liujiajia-wq/DC-Motor-PID-Speed-Control-Based-on-STM32-and-Modbus/STM32直流电机PID闭环调速系统_项目技术文档.docx

嵌入式运动控制 · 项目技术文档

基于 STM32F103C8T6 与 Modbus-RTU 的
直流电机增量式 PID 闭环调速系统

硬件设计 · 下位机固件 · Qt 上位机 · 通信协议 · 参数整定

文档类型：项目技术文档（设计 / 实现 / 调试全记录）
硬件平台：STM32F103C8T6 + TB6612FNG + 11 线光电编码器
软件平台：STM32CubeMX + HAL 库 + Keil MDK-ARM 5 / Qt 5.9
控制算法：增量式 PID，控制周期 100 ms，PWM 频率 1 kHz
通信方式：Modbus-RTU 从机，USART2，115200 bps，站号 0x01
文档版本：V1.0　　编写日期：2026 年 10 月 27 日

本文档依据工程源码逐文件核对编写，凡与代码不一致处均以代码实现为准

目 录

## 摘要

本项目以 STM32F103C8T6 为核心控制器，构建了一套"编码器测速—增量式 PID 运算—PWM 调压"的直流电机速度闭环系统。系统采用 TB6612FNG 双通道 H 桥驱动 12 V 减速直流电机，通过 TIM3 的正交解码功能读取电机轴端光电编码器脉冲，以 100 ms 为控制周期计算转速并执行增量式 PID 运算，输出 1 kHz PWM 占空比驱动电机；同时以 USART2 承载 Modbus-RTU 从机协议，与基于 Qt 5.9 开发的 PC 上位机通信，实现目标速度下发、启停与正反转控制、目标/实际速度实时回传与响应曲线绘制；板载 0.96 寸 I²C OLED 同步显示目标值、实测值与当前 PWM 输出。

本文档按照"总体设计—硬件设计—下位机软件—上位机软件—通信协议—参数整定—调试排故"的顺序，完整记录该项目的设计依据、关键参数推导、模块实现要点与实测调参过程，并单列一章说明既有文档与当前代码之间的差异、以及代码中尚未闭环的已知问题，供后续维护与二次开发参考。

关键词：STM32F103C8T6；增量式 PID；TB6612FNG；正交编码器；Modbus-RTU；Qt 上位机

## 1 项目概述

本章说明项目的立论依据、要实现的功能边界与可验收的技术指标，并统一后文使用的术语与记号。

### 1.1 项目背景

直流减速电机具有转矩大、响应快、调速方便的特点，是小型移动机器人、传送机构、云台与教学实验平台最常见的执行器。开环调速直接给定 PWM 占空比，电机实际转速会随负载、电源电压、温升与摩擦变化而漂移，无法满足"设定多少就跑多少"的需求。

引入编码器构成闭环后，转速成为可控量。相比位置式 PID，增量式 PID 的输出是占空比的"增量"，天然不含积分累积项的历史包袱，切换目标值或停机时不需要额外清积分，抗积分饱和、抗扰能力更强，非常适合以 PWM 为执行量的电机调速场景，因此本项目选用增量式 PID 作为核心算法。

### 1.2 设计目标与功能清单

- 电机速度闭环：以 100 ms 为周期测量实际转速并执行增量式 PID，稳态转速跟随设定值；
- 方向与启停控制：支持正转、反转、停止三种运行状态，停止时立即封锁 PWM 并清零 PID 状态；
- 手动调速：目标速度以 0~100 的无量纲档位表示，与 0~100% 占空比等量映射；
- 本地显示：OLED 实时显示目标速度、实际速度与 PID 输出的 PWM 值；
- 远程通信：Modbus-RTU 从机，支持 0x03 读寄存器、0x06 写寄存器，可由任意 Modbus 主站或调试助手访问；
- 上位机监控：Qt 桌面程序完成串口配置、电机操作、目标/实际速度双曲线绘制与原始报文日志；
- 可维护性：各功能按模块拆分（驱动、测速、算法、通信、显示），便于单独替换与移植。

### 1.3 主要技术指标

项目 | 指标 | 依据
主控 | STM32F103C8T6，Cortex-M3，72 MHz，64 KB Flash / 20 KB RAM | 最小系统板
电机 | 12 V 减速直流电机，输出轴 170 rpm，减速比 1:8 | 实测铭牌参数
编码器 | 11 线光电增量式，A/B 双相，四倍频后 44 计数/转（电机轴） | 编码器规格
调速范围 | 0~100 档（对应 0~100% 占空比），实测下限约 15~20 档 | 实测
PWM 频率 | 1 kHz（TIM4：72 MHz / 72 / 1000） | MX_TIM4_Init
控制周期 | 100 ms（测速 + PID + PWM 更新） | main.c 软定时
通信 | USART2，115200 bps，8 数据位，无校验，1 停止位 | MX_USART2_UART_Init
协议 | Modbus-RTU 从机，站号 0x01，功能码 0x03 / 0x06 | modbus.c
显示 | 0.96 寸 OLED，SSD1306，I²C 100 kHz | i2c.c / oled.c
稳态性能 | 稳态误差 0（回读计数等于目标值），无明显持续振荡 | 实测

### 1.4 术语与记号

术语 | 含义
CCR | 定时器比较寄存器值，决定 PWM 高电平计数值
ARR | 定时器自动重装载值，决定 PWM 周期
占空比 | CCR / (ARR + 1) × 100%，本项目取 0~99 对应 0~99%
计数 | 本文特指"100 ms 内编码器四倍频脉冲个数"，即转速的数字化表示，量纲 计数/100 ms
增量式 PID | 输出为控制量增量的 PID 形式，需累加得到实际控制量
帧间隔 | Modbus-RTU 中用于划分报文边界的静默时间，本项目取 5 ms

## 2 系统总体设计

在进入具体电路与代码之前，先给出系统的分层组成、闭环数据流、时间基准与量纲约定——这四项决定了后续所有模块的实现方式。

### 2.1 系统组成

系统按职责分为四层：

- 执行层：TB6612FNG 与直流减速电机，接收方向电平与 PWM，输出机械转速；
- 传感层：电机轴端 11 线光电编码器，把转速转换为正交脉冲；
- 控制层：STM32F103C8T6，完成测速、PID 运算、PWM 生成、协议解析与显示刷新；
- 交互层：0.96 寸 OLED（本地）与 Qt 上位机（远程，经 USB-TTL 与 USART2 相连）。

┌──────────── 上位机（Qt 5.9） ────────────┐
│ 串口配置 / 启停 / 调速 / 双曲线 / 报文日志 │
└───────────────┬──────────────────────────┘
│ USB（虚拟串口，115200 8N1）
┌─────┴─────┐
│ CH340 TTL │
└─────┬─────┘
PA2(TX)/PA3(RX) ← Modbus-RTU
┌───────────────┴──────────────────────────────┐
│ STM32F103C8T6 @72 MHz │
│ TIM3 正交解码测速 → 增量式 PID → TIM4 PWM │
│ I2C1 → OLED USART2 → Modbus 从机 │
└───────┬───────────────────────┬──────────────┘
PA6/PA7 │ PB6 PWM│ PB0/PB1 方向
┌───────┴────────┐ ┌───────┴────────┐
│ 11 线编码器 A/B │ │ TB6612FNG │
└───────┬────────┘ └───────┬────────┘
│ 同轴 12V │
┌───┴────────────────────────┴───┐
│ 12 V 减速直流电机（1:8, 170rpm）│
└───────────────────────────────┘

### 2.2 控制回路与数据流

单个控制周期内，数据沿"测量 → 比较 → 决策 → 执行"的闭环流动：

1. 读取 TIM3 计数器，与上一周期值作差得到本周期的编码器增量，取绝对值作为实际速度反馈；
2. 与 Modbus 写入的目标速度求偏差 e(k)；
3. 增量式 PID 计算占空比增量并累加到 pwm_out，限幅到 0~99；
4. 按当前命令字设置 AIN1/AIN2 方向电平，并把 pwm_out 写入 TIM4 CCR1；
5. 同时把目标值、实测值、PWM 值刷到 OLED；Modbus 主站的读请求在任意时刻由主循环响应，返回最近一次有效的目标值与实测值。

### 2.3 时间基准与任务调度

系统未使用 RTOS，全部任务由主循环 + 一个串口接收中断构成，节奏由 HAL_GetTick() 软定时和字节中断的静默时间共同决定。

任务 | 触发方式 | 周期/条件 | 实现位置
串口字节接收 | USART2 接收中断 | 每字节一次 | HAL_UART_RxCpltCallback()
帧边界判定 | 轮询 | 接收静默 ≥ 5 ms | Modbus_Parse()
测速 + PID + PWM | 软定时 | 100 ms | Motor_PID_Loop()
OLED 刷新 | 跟随 PID 节拍 | 100 ms | Motor_PID_Loop() 内
上位机轮询读 | Qt 定时器 | 200 ms | MainWindow::slotAutoReadSpeed()

说明：控制周期用软定时而非硬件定时中断，好处是不占用中断资源、便于在线调整周期；代价是周期存在主循环阻塞带来的抖动（OLED 的 I²C 阻塞发送是主要来源）。当串口报文密集时，抖动会略微增大，但对 100 ms 级别的速度环影响可忽略。

### 2.4 量纲统一与速度标定

闭环要成立，反馈量与设定量必须同量纲。本项目刻意把"速度"定义为"100 ms 内的编码器计数"，让 100 这个数字同时对应"满速"与"100% 占空比"，从而把 PID 参数化为无量纲形式。推导如下：

- 编码器 11 线，A/B 双相四倍频后每转计数 = 11 × 4 = 44；
- 减速比 1:8，输出轴 170 rpm 时电机轴转速 = 170 × 8 = 1360 rpm ≈ 22.67 r/s；
- 每秒计数 = 22.67 × 44 ≈ 997.3；
- 100 ms 内计数 = 997.3 × 0.1 ≈ 99.7，取整为 100。

因此 计数/100 ms ≈ 占空比%，反馈量与控制量数值可比，Kp 可以直接理解为"每 1 个计数偏差对应多少个百分点的占空比增量"，整定时无需再换算量纲。

一致性提示：由于四倍频与减速比固定，上式成立的前提是 TIM3 工作在编码器模式且不额外分频（PSC=0）。若更换编码器线数或减速比，必须重新标定该映射，否则 PID 参数需整体重调。

### 2.5 工程文件组织

下位机工程由 STM32CubeMX 生成骨架，用户功能代码以独立 .c/.h 文件放在 Core/Src 与 Core/Inc 下。

文件 | 职责
Core/Src/main.c | 初始化调度、主循环、100 ms PID 节拍
Core/Src/DCmotor.c/.h | TB6612 方向控制、PWM 占空比、增量式 PID
Core/Src/encode.c | 编码器定时器启动与增量读取
Core/Src/modbus.c/.h | CRC16、报文解析、寄存器读写、应答发送
Core/Src/usart.c | USART2 配置与单字节接收中断回调
Core/Src/tim.c | TIM1/2/3/4 的 CubeMX 配置
Core/Src/gpio.c / i2c.c | 引脚与 I²C1（OLED）配置
Core/Src/oled.c | SSD1306 驱动与字符显示
Core/Src/SG90.c | 舵机控制（前序实验遗留，当前未参与主流程）
MDK-ARM/*.uvprojx | Keil MDK 工程
STM32F103C8T6_MOTOR.ioc | CubeMX 工程配置
上位机-QT/Modbus/ModbusRtu | Qt 上位机源码

## 3 硬件设计

本章按“主控—驱动—传感—显示—通信”的顺序给出各模块的选型依据、关键参数与接线关系，并集中列出全部引脚分配，便于照表接线与逐点排查。

### 3.1 主控最小系统

STM32F103C8T6 采用 LQFP48 封装，片上 64 KB Flash、20 KB SRAM，最高主频 72 MHz。系统时钟由外部 8 MHz 晶振经 PLL ×9 倍频得到 72 MHz；AHB 不分频（72 MHz），APB2 不分频（72 MHz），APB1 二分频（36 MHz）。定时器时钟方面，APB2 上的 TIM1 为 72 MHz，APB1 上的 TIM2/3/4 经倍频后同为 72 MHz，这也是后文 PWM 频率计算的基准。

调试接口使用 SWD（PA13/PA14），板载 PC13 LED 已在 GPIO 初始化时置高（熄灭），当前仅作为可用指示灯保留。

### 3.2 引脚分配

引脚 | 复用/方向 | 外设与配置 | 连接对象 | 说明
PA0 | 输入（上拉） | TIM2_CH1，编码器模式 | EC11 旋钮 A 相 | 前序实验预留，当前未启用
PA1 | 输入（上拉） | TIM2_CH2，编码器模式 | EC11 旋钮 B 相 | 同上
PA2 | 复用推挽 | USART2_TX | CH340 RXD | Modbus 发送
PA3 | 浮空输入 | USART2_RX | CH340 TXD | Modbus 接收，开中断
PA6 | 浮空输入 | TIM3_CH1，编码器模式 | 电机编码器 A 相 | 测速
PA7 | 浮空输入 | TIM3_CH2，编码器模式 | 电机编码器 B 相 | 测速
PA8 | 复用推挽 | TIM1_CH1（50 Hz） | SG90 信号 | 前序实验遗留
PA9 | 复用推挽 | TIM1_CH2（50 Hz） | 预留 | 前序实验遗留
PA13/PA14 | SWD | SYS_JTMS/JTCK | 调试器 | 下载调试
PB0 | 推挽输出 | GPIO_OUTPUT | TB6612 AIN1 | 方向控制
PB1 | 推挽输出 | GPIO_OUTPUT | TB6612 AIN2 | 方向控制
PB6 | 复用推挽 | TIM4_CH1（1 kHz PWM） | TB6612 PWMA | 调速
PB8 | 复用开漏 | I2C1_SCL（重映射） | OLED SCL | 显示
PB9 | 复用开漏 | I2C1_SDA（重映射） | OLED SDA | 显示
PC13 | 推挽输出 | GPIO_OUTPUT | 板载 LED | 备用指示

注意：PB6 与 PB8/PB9 的 I²C 重映射共存于同一端口，CubeMX 中必须勾选 I2C1 重映射，否则 OLED 无显示。

### 3.3 电机驱动 TB6612FNG

TB6612FNG 内部为双 H 桥，单通道持续电流 1.2 A、峰值 3.2 A，支持 2.5~13.5 V 电机电源，逻辑侧 2.7~5.5 V，控制接口为"1 路 PWM + 2 路方向"。本项目只使用 A 通道：

STBY | AIN1 | AIN2 | PWMA | 电机状态
高 | 1 | 0 | PWM | 正转，转速随占空比
高 | 0 | 1 | PWM | 反转，转速随占空比
高 | 1 | 1 | × | 短路制动（快速刹车）
高 | 0 | 0 | × | 停止（滑行）
低 | × | × | × | 待机，输出高阻

固件中 Motor_Forward()/Motor_Backward()/Motor_Brake()/Motor_Stop() 四个函数分别对应上述四种状态，Motor_Run(mode, speed) 在其上再叠加占空比设置。STM32 侧只占用 3 个引脚（PB0、PB1、PB6），VM 接 12 V 电机电源，VCC 接 3.3 V 逻辑电源，GND 与主控、电源共地。

STBY 在代码中未被驱动，需硬件直接接 VCC（或 3.3 V）保持常使能，否则芯片处于待机、电机不动。

### 3.4 编码器接口

编码器为 11 线光电增量式，A/B 两相正交输出，安装于电机后端轴（减速箱之前），因此计数反映的是电机轴转速而非输出轴转速。TIM3 配置为编码器模式 TIM_ENCODERMODE_TI12，两路输入均直连 TI1/TI2，PSC=0、ARR=65535，即 16 位自由计数、硬件自动四倍频、方向由硬件根据 A/B 相位关系判断（计数器自增/自减）。

固件读取方式为"差分法"：每 100 ms 取一次计数值，与上次值相减得到增量。由于 16 位计数器会回绕，差值必须按有符号 16 位解释，代码中写作：

int16_t get_BMQ370_encode_delte(void)
{
uint16_t now_cnt = __HAL_TIM_GET_COUNTER(&htim3);
int16_t delta = (int16_t)(now_cnt - last_cnt); /* 16 位回绕自动正确 */
last_cnt = now_cnt;
return abs(delta); /* 当前仅取幅值 */
}

采用差分而非"清零重计"，避免了每周期写 CNT 带来的丢脉冲风险；abs() 使反馈只保留转速幅值，方向完全由命令字决定，因此本系统不具备"反向制动"能力（详见 §8.3）。

### 3.5 显示与人机接口

OLED 为 0.96 寸 SSD1306，128×64 单色，I²C 接口，7 位地址 0x3C，SCL 100 kHz。固件 oled.c 内置 6×8 与 8×16 字库，oled_show_string(x, y, str) 中 y 为页地址（每页 8 行像素）。当前界面占用 4 行：

行（页） | 内容 | 示例
0 | 目标速度 | target:060
2 | 实际速度 | real:058
4 | 编码器计数 | cnt:01234
6 | PID 输出占空比 | pwm:62.35

### 3.6 通信接口

PC 与 STM32 之间使用 CH340 USB 转 TTL 模块，仅接 TXD/RXD/GND 三线（无硬件流控）。波特率 115200，8N1。CH340 的 TXD 接 PA3（MCU 的 RX），RXD 接 PA2（MCU 的 TX），交叉连接；若接成同名相连则表现为"能发不能收"或完全无响应。

### 3.7 供电与抗干扰

- 12 V 电机电源与 3.3 V 逻辑电源分开供电，共地单点汇合，避免电机换向瞬间的电流冲击拉低 MCU 电压导致复位；
- 电机两端并联 0.1 μF 瓷片电容抑制换向火花，编码器信号线使用双绞或屏蔽线并远离电机引线；
- TB6612 的 VM 就近放置 100 μF 电解 + 0.1 μF 瓷片去耦；
- 若出现"电机一转上位机就掉线"，优先检查共地质量与 USB 供电是否与电机电源共地形成地环路。

## 4 下位机软件设计

下位机软件以 STM32CubeMX 生成的 HAL 骨架为基础，用户功能按驱动、测速、算法、通信、显示五个模块拆分；模块之间通过三个全局状态量（目标速度、实测速度、命令字）耦合，结构简单、易于在线调试。

### 4.1 开发环境与外设配置

- IDE：Keil MDK-ARM 5（工程 MDK-ARM/STM32F103C8T6_MOTOR.uvprojx）；
- 配置工具：STM32CubeMX（工程 STM32F103C8T6_MOTOR.ioc）；
- 驱动库：STM32F1xx HAL Driver；
- 下载调试：SWD，ST-Link / DAP-Link 均可。

外设配置汇总：

外设 | 工作模式 | 关键参数 | 计算结果 | 用途
TIM1 | PWM，CH1/CH2 | PSC=71，ARR=19999 | 72 MHz/72/20000 = 50 Hz | 舵机信号（遗留）
TIM2 | 编码器 TI12 | PSC=0，ARR=65535 | 16 位四倍频计数 | EC11（未启用）
TIM3 | 编码器 TI12 | PSC=0，ARR=65535，IC2 下降沿 | 16 位四倍频计数 | 电机测速
TIM4 | PWM，CH1 | PSC=71，ARR=999 | 72 MHz/72/1000 = 1 kHz | 电机调速
USART2 | 异步 | 115200 8N1，NVIC 优先级 6 | — | Modbus-RTU
I2C1 | 主机 | 100 kHz，7 位地址，重映射 | — | OLED
SysTick | 1 ms | HAL 时基 | — | HAL_GetTick()

### 4.2 初始化流程

main() 的执行顺序为：HAL_Init() → SystemClock_Config()（HSE 8 MHz ×9 = 72 MHz）→ MX_GPIO_Init() → MX_TIM1_Init() → MX_TIM2_Init() → MX_I2C1_Init() → MX_TIM3_Init() → MX_TIM4_Init() → MX_USART2_UART_Init() → 用户初始化。

用户初始化段完成四件事：

1. oled_init() 点亮并清屏；
2. init_BMQ370_encode_tim() 启动 TIM3 编码器接口；
3. Motor_init() 启动 TIM4 的 PWM 通道（此时 CCR=0，电机不转）；
4. 以单字节模式开启 USART2 接收中断，进入"来一个字节进一次中断"的接收方式。

### 4.3 主循环与 100 ms 节拍

主循环是典型的"非阻塞轮询 + 软定时"结构：

while (1)
{
Modbus_Parse(); /* 每圈都尝试解析，内部自判帧边界 */

if (HAL_GetTick() - pid_time >= 100) /* 100 ms 到点 */
{
pid_time = HAL_GetTick();
Motor_PID_Loop(); /* 测速 + PID + PWM + 显示 */
}
}

Modbus_Parse() 内部自带帧完整性判断（静默 ≥5 ms 且长度合法才处理），因此放在主循环高频调用是安全的；PID 任务用"当前节拍减上一节拍"的方式定时，不依赖中断，便于调试时临时改周期观察响应。

### 4.4 PWM 输出模块

TIM4 计数时钟 1 MHz（72 MHz / 72），ARR=999 → PWM 周期 1 ms（1 kHz），CCR 取值 0~999 对应 0~100% 占空比。Motor_SetSpeed(speed) 把 0~100 的档位换算为 CCR：

void Motor_SetSpeed(uint8_t speed)
{
if (speed > 100) speed = 100;
uint16_t arr = 999;
uint16_t ccr = (speed * arr) / 100;
__HAL_TIM_SET_COMPARE(&htim4, TIM_CHANNEL_1, ccr);
}

选择 1 kHz 而非更高频率，是为了兼顾两方面：频率太低（<200 Hz）电机有可闻啸叫与明显转矩脉动；频率太高则 H 桥开关损耗与驱动板发热上升，且在低速小占空比时线性度变差。1 kHz 是小型有刷直流电机常见的工作点。

### 4.5 测速模块

测速逻辑已在 §3.4 说明，此处补充工程上的两点处理：

- 读取时机固定：测速只在 Motor_PID_Loop() 内调用一次，保证"一个控制周期一次采样"，避免不同调用点的采样窗口不一致导致速度值跳动；
- 无效帧处理：若电机被外力堵转或静止，增量为 0，PID 会持续增大输出直至限幅，属正常闭环行为，需靠软件或硬件的堵转保护兜底（当前未实现）。

### 4.6 增量式 PID 模块

本模块是整个控制器的核心。下面先给出算法形式与参数含义，再说明代码实现中的边界处理与已知限制。

#### 4.6.1 算法形式

离散增量式 PID 的输出是控制量的增量：

Δu(k) = Kp·[e(k) − e(k−1)] + Ki·e(k) + Kd·[e(k) − 2e(k−1) + e(k−2)]
u(k) = u(k−1) + Δu(k)

其中 e(k) = 目标速度 − 实际速度，Ki = Kp·T/Ti，Kd = Kp·Td/T，采样周期 T = 100 ms。三部分分别对应：比例项反映偏差的"变化趋势"、积分项消除稳态误差、微分项抑制超调。

与位置式相比，增量式只需保存最近两次偏差，不需要保存历史误差总和，停机后重新启动不会有"积分残留"造成的冲击，这正是本项目在 motor_cmd == 0 时能干净归零的原因。

#### 4.6.2 参数与实现

当前生效参数为第三轮整定结果：

参数 | 取值 | 说明
Kp | 0.40 | 每 1 个计数偏差约产生 0.4% 占空比增量
Ki | 0.08 | 消除稳态误差，偏小以避免低速振荡
Kd | 0.09 | 抑制超调，约为 Kp 的 22%
PWM_MAX | 99 | 输出上限（对应 99% 占空比）
PWM_MIN | 0 | 输出下限
控制周期 | 100 ms | 与测速窗口一致

核心实现：

float PID_Inc_Calc(uint8_t target, uint8_t real)
{
err = target - real;

float output = Kp * (err - last_err)
+ Ki * err
+ Kd * (err - 2 * last_err + last_last_err);

last_last_err = last_err;
last_err = err;

pwm_out += output; /* 增量累加 */

if (pwm_out > PWM_MAX) pwm_out = PWM_MAX; /* 抗饱和限幅 */
if (pwm_out < PWM_MIN) pwm_out = PWM_MIN;

return pwm_out;
}

#### 4.6.3 边界处理

- 限幅：累加后立即钳位到 [0, 99]，防止目标突变时输出冲高导致过流；
- 停机复位：motor_cmd == 0 时把 pwm_out、err、last_err、last_last_err 全部清零并调用 Motor_Stop()，保证下次启动从零开始、无历史误差残留；
- 死区：源码中定义了 MOTOR_DEAD_ZONE 22 并保留了死区补偿代码，但当前被注释未启用，低速段靠 P 项自行"爬出"静摩擦区（这是低速启动略慢的直接原因）；
- 类型约束：PID_Inc_Calc 形参为 uint8_t，有效范围 0~255，而速度量程为 0~100，当前不会溢出；若将来把量程扩到 255 以上需改为 int16_t。

### 4.7 Modbus 从机模块

本模块把电机控制器包装成一个标准的 Modbus 从机设备。先说明接收状态机与报文校验，再说明寄存器处理与应答构造。

#### 4.7.1 接收状态机

接收采用"单字节中断 + 静默时间判帧"的轻量方案，不依赖 DMA 和定时器捕获：

void HAL_UART_RxCpltCallback(UART_HandleTypeDef *huart)
{
static uint8_t rx_byte;
if (huart->Instance == USART2)
{
if (HAL_GetTick() - modbus_rx_tick < MODBUS_TIMEOUT) /* 帧内 */
modbus_rx_buf[modbus_rx_len++] = rx_byte;
else /* 帧头 */
{ modbus_rx_len = 0; modbus_rx_buf[modbus_rx_len++] = rx_byte; }

modbus_rx_tick = HAL_GetTick();
HAL_UART_Receive_IT(&huart2, &rx_byte, 1); /* 重新武装 */
}
}

MODBUS_TIMEOUT 取 5 ms。Modbus-RTU 标准要求帧间隔 3.5 个字符时间，115200 bps 下约为 0.3 ms；取 5 ms 是为容忍上位机逐字节发送时的调度抖动，代价是最大 5 ms 的响应延迟，对 200 ms 轮询的上位机完全够用。

#### 4.7.2 CRC16

采用 Modbus 标准 CRC-16/MODBUS：初值 0xFFFF，多项式 0xA001（反向），逐字节异或后移位 8 次，结果为 16 位，低字节在前、高字节在后发送。

uint16_t Modbus_CRC16(uint8_t *buf, uint16_t len)
{
uint16_t crc = 0xFFFF;
for (uint16_t i = 0; i < len; i++)
{
crc ^= buf[i];
for (uint8_t j = 0; j < 8; j++)
crc = (crc & 1) ? ((crc >> 1) ^ 0xA001) : (crc >> 1);
}
return crc;
}

#### 4.7.3 解析流程

Modbus_Parse() 的处理顺序为：判定帧结束 → 长度校验（≥8）→ 拷贝并清空缓冲 → CRC 校验 → 站号校验 → 按功能码分支处理：

- 0x03 读保持寄存器：若 起始寄存器=0、数量=2，返回 9 字节响应（目标速度、实际速度各占 1 个寄存器）；若 数量=1，返回 7 字节响应（兼容旧指令）；
- 0x06 写单个寄存器：寄存器 0 写目标速度（>100 时钳位到 100），寄存器 1 写命令字（>2 时归零），按协议原样回显 8 字节请求帧作为应答。

解析完成后 modbus_rx_len 已在取帧时清零，避免同一帧被重复处理。

### 4.8 中断与优先级

中断 | 优先级（抢占/子） | 用途 | 处理时长
SysTick | 0/0 | HAL 时基、毫秒计数 | 极短
USART2 | 6/0 | 单字节接收 | 极短（仅搬字节 + 重开中断）
无其他业务中断 | — | PID 与解析都在主循环 | —

所有耗时操作（I²C 刷屏、串口发送应答）都在主循环上下文执行，中断内不做任何阻塞调用，避免影响时基与接收。

## 5 上位机软件设计

上位机同时承担“人机接口”与“协议主站”两个角色，用 Qt Widgets 纯代码实现，界面层与通信层通过信号槽解耦，便于单独替换通信实现或迁移到其他框架。

### 5.1 开发环境

- Qt 5.9（GCC 64-bit 桌面套件），Qt Creator 打开 上位机-QT/Modbus/ModbusRtu/ModbusRtu.pro；
- 依赖模块：core gui widgets serialport charts（曲线实际由自绘实现，charts 为预留）；
- C++11，界面以纯代码方式构建（不依赖 .ui 文件），统一深色主题。

### 5.2 模块划分

类 | 文件 | 职责
MainWindow | mainwindow.cpp | 界面构建、控件与槽绑定、状态灯、日志、把数据推给曲线
SerialPortManager | serialportmanager.cpp | 串口开关、Modbus 组帧/CRC/发送、收包解析、发信号
PlotWidget | plotwidget.cpp | QPainter 手绘坐标网格与目标/实际双曲线

三者以信号槽解耦：SerialPortManager 只负责"字节 ↔ 语义"，解析出目标/实际速度后发 speedDataUpdate(int,int)；MainWindow 收到后更新文字并调用 m_plotWidget->addData()。

### 5.3 Modbus 主站实现

- 组帧：makeReadFrame() / makeWriteRegFrame() 分别构造 0x03 / 0x06 请求，CRC 由同一个 calcCRC16() 生成，低字节在前；
- 轮询：QTimer 200 ms 触发 readSpeedRegs()，发送 01 03 00 00 00 02 + CRC；
- 收包解析：onReadyRead() 直接 readAll() 后交给 parseModbus()，后者只接受"长度 9、地址 0x01、功能码 0x03、字节数 0x04"的响应帧，从中取出两个 16 位寄存器并发出信号；
- 原始报文日志：sendRawData / recvRawData 信号把每一帧以十六进制写入界面日志区，便于对照协议排查。

未做分包拼帧处理：解析要求一次 readAll() 恰好得到完整 9 字节。在 115200 bps、单帧 9 字节的条件下通常成立，但若 USB 转串口驱动把一帧拆成两次上报，会出现漏帧（表现为曲线偶尔断点）。改进方向见 §8.3。

### 5.4 实时曲线

PlotWidget 自行绘制：纵向 0~100（速度计数），横向 10 格、每格 200 ms，最多缓存 120 个采样点（约 24 s 窗口），超出后从头部丢弃。目标速度用蓝色（#42A5F5）、实际速度用绿色（#66BB6A）绘制，右侧有图例。由于采样周期 200 ms 与下位机 100 ms 控制周期不同步，曲线反映的是"每 200 ms 的车速快照"，用于观察趋势足够，不适合做精确的阶跃响应指标测量。

### 5.5 界面与操作流程

左侧为"串口状态灯 + 串口配置 + 电机控制"两栏，右侧为"曲线 + 报文日志"。典型操作顺序：

1. 点击"串口"下拉框选择 CH340 对应端口（如 COM3），波特率保持 115200，点"打开串口"（状态灯由红转绿，按钮变为"关闭串口"，200 ms 轮询启动）；
2. 在输入框填写目标速度（0~100），点"设置速度"；
3. 点"电机启动"使电机按当前目标速度闭环运行（内部下发命令字，见 §8.3 的一致性说明）；
4. 观察左侧"目标速度/当前速度"数值与右侧双曲线；
5. 点"电机停止"停机（PWM 归零、PID 状态清零）。

## 6 通信协议规范

本章从协议角度给出该从机设备的完整接口定义，包括帧格式、寄存器映射、报文示例与异常处理，任何第三方 Modbus 主站或调试工具均可据此直接对接。

### 6.1 物理层

RS-232 电平经 CH340 转换的 TTL 串口，115200 bps、8 数据位、无校验、1 停止位、无流控；从机地址固定 0x01；一帧内字节间隔 < 5 ms，帧间静默 ≥ 5 ms。

### 6.2 帧格式

功能码 | 方向 | 帧长 | 结构
0x03 | 主 → 从 | 8 | 地址 + 0x03 + 起始寄存器H/L + 寄存器数量H/L + CRC_L + CRC_H
0x03 | 从 → 主（读 2 个） | 9 | 地址 + 0x03 + 0x04 + 数据1H/L + 数据2H/L + CRC_L + CRC_H
0x03 | 从 → 主（读 1 个） | 7 | 地址 + 0x03 + 0x02 + 数据H/L + CRC_L + CRC_H
0x06 | 主 → 从 | 8 | 地址 + 0x06 + 寄存器H/L + 值H/L + CRC_L + CRC_H
0x06 | 从 → 主 | 8 | 原样回显请求帧

### 6.3 寄存器映射

地址 | 名称 | 读（0x03） | 写（0x06） | 取值范围
0x0000 | 目标速度 | 返回当前目标速度 | 设置目标速度 | 0~100，越界钳位到 100
0x0001 | 速度反馈 / 命令字 | 返回最近一次实测速度 | 设置运行命令 | 读：0~100；写：0 停止、1 正转、2 反转，>2 归零

设计说明：寄存器 0x0001 是"写命令、读反馈"的复用设计。这样上位机一次读 2 个寄存器即可同时拿到目标值与实测值（省一半报文），代价是通用 Modbus 调试工具"写后读回命令"会读到速度值而非命令值，容易造成误判。若作为正式产品，建议拆分为 0x0001（命令，读写）与 0x0002（实测速度，只读）。

### 6.4 报文示例

读取目标速度与实际速度（主站 → 从站）：

01 03 00 00 00 02 C4 0B
地址 功能码 起始=0x0000 数量=2 CRC16=0x0BC4（低字节在前）

从站应答（目标 50、实测 48）：

01 03 04 00 32 00 30 5B E8
寄存器0=0x0032=50，寄存器1=0x0030=48，CRC16=0xE85B

写目标速度 50（主站 → 从站，从站原样回显）：

01 06 00 00 00 32 08 1F

写运行命令"正转"（命令字 1）：

01 06 00 01 00 01 19 CA

CRC 校验方法：除最后两字节外的全部字节参与计算，结果为 16 位，先发低字节再发高字节。若手算结果与上例不符，先检查字节序，再检查是否误用了 CRC-16/CCITT（0x1021 正向）而非 CRC-16/MODBUS（0xA001 反向）。

### 6.5 异常处理

- 帧长不足 8 字节、CRC 错误、站号不匹配：静默丢弃，不应答（符合 Modbus 从机惯例）；
- 起始寄存器或寄存器数量不在支持范围：不应答（当前未实现异常响应帧 0x83）；
- 写值越界：不报错，按钳位规则处理（速度 >100 → 100，命令 >2 → 0），保证执行器状态始终合法。

## 7 PID 参数整定与实验结果

本章记录从初始参数到最终参数的三轮整定过程、每一轮的现象与判断依据，以及最终参数下的实测性能。

### 7.1 被控对象特性

被控对象是"占空比 → 转速"的一阶惯性加纯延迟环节：电枢电压改变后，因电感与转动惯量，转速需经数十毫秒才开始响应，且存在静摩擦死区（占空比低于约 20% 时电机可能不转）。这类对象的整定原则是：先给足 P 让系统动起来，再用较小的 I 消除静差，最后用 D 压制超调。

### 7.2 整定过程

采用工程试凑法，固定控制周期 100 ms，逐轮调整并观察上位机双曲线与 OLED 数值：

轮次 | Kp | Ki | Kd | 实测现象 | 结论
1 | 0.50 | 0.15 | 0.05 | 上升很快，但超调明显，转速在目标值附近持续小幅振荡，稳态时数值来回跳动 | P、I 偏大，振荡
2 | 0.35 | 0.08 | 0.08 | 振荡基本消失，稳态平稳，但上升偏慢，低速段有"爬行"感 | 偏保守，响应慢
3 | 0.40 | 0.08 | 0.09 | 上升时间约 0.4~0.5 s，超调小于 5%，稳态回读值等于目标值，无持续振荡 | 采用

调整逻辑：第 1 轮振荡的主因是 Ki 偏大（0.15 在 100 ms 周期下积分作用过强）；第 2 轮把 Ki 减半后振荡消失但响应迟钝，于是第 3 轮把 Kp 从 0.35 提到 0.40 提升响应，并把 Kd 从 0.08 微调到 0.09 抑制由此带来的轻微过冲。

### 7.3 阶跃响应结果

给定目标从 0 跳到 60 计数（约 60% 占空比稳态工作点），观测到：

指标 | 实测值 | 说明
上升时间（10%→90%） | 约 0.4 s | 约 4 个控制周期
超调量 | 小于 5%（≤3 个计数） | 第 3 轮参数下几乎看不出过冲
调节时间 | 约 0.8 s | 进入 ±2 计数带并不再离开
稳态误差 | 0 | 稳态时 real 与 target 数值一致
稳态波动 | ±1 计数 | 主要是编码器量化误差（1 计数分辨率）

数据来自 OLED 与上位机曲线的目测记录，未用示波器/逻辑分析仪做定量测量。若需精确指标，建议在固件中增加"每周期通过串口上传 target/real/时间戳"的调试帧，由上位机按真实时间轴绘图。

### 7.4 结论

在 0~100 全量程内，系统均能稳定跟随设定值，无持续振荡、无稳态误差；低速段（<20）因死区未补偿，启动略迟缓；目标突变大于 50 个计数时会出现一次约 3 个计数的瞬时过冲，属可接受范围。

## 8 调试与故障排查

本章按实际调试顺序给出分步验证方法，汇总联调中遇到的典型故障及其处理办法，并如实列出当前代码中尚未闭环的问题与改进建议。

### 8.1 分步调试流程

建议按"先开环、后闭环；先本地、后远程"的顺序推进，每步验证通过再进入下一步：

1. 时钟与下载：烧录点灯程序，确认 72 MHz 时钟与 SWD 正常；
2. PWM 开环：不接电机，用示波器测 PB6，确认 1 kHz、占空比随 Motor_SetSpeed() 变化；
3. 驱动方向：接电机，调用 Motor_Run(1,50) / Motor_Run(2,50) 确认正反转与 PB0/PB1 电平对应关系；
4. 编码器：手转电机轴，观察 OLED 上 cnt 单调增减，确认 A/B 未接反、无丢脉冲；
5. 测速标定：给定固定占空比，记录 100 ms 计数，核对是否与 §2.4 的推导量级一致；
6. 闭环：接入 PID，先把 Kp 从 0.1 逐步加大到系统开始跟随，再加 I、D；
7. 通信：先用 Modbus 调试助手（如 Modbus Poll / 串口助手手动组帧）验证 0x03/0x06，再接 Qt 上位机；
8. 联调：上位机 200 ms 轮询 + 曲线，观察阶跃与扰动响应。

### 8.2 典型问题与排查

现象 | 可能原因 | 排查与处理
上电电机不转，OLED 正常 | STBY 未拉高；TB6612 未供 VM；PWM 通道未 HAL_TIM_PWM_Start | 量 STBY 电平；量 VM 12 V；确认 Motor_init() 被调用
电机只朝一个方向转 | AIN1/AIN2 接线顺序或命令字映射错误 | 交换 AIN1/AIN2 或核对命令字定义
转速读数恒为 0 | 编码器 A/B 接反或未上拉；TIM3 编码器未启动 | 手转轴看 cnt 是否变化；确认 init_BMQ370_encode_tim()
转速读数跳动大 | 编码器电源噪声、信号线过长、未双绞 | 加 0.1 μF 滤波、缩短走线、单独供电
速度上不去（卡在某个值） | 电源限流、机械负载过大、PWM_MAX 限幅 | 量电机电流；确认 PWM_MAX=99 是否够用
低速不转、一给就冲到高速 | 静摩擦死区；Ki 过大 | 启用 MOTOR_DEAD_ZONE 补偿；减小 Ki
OLED 无显示 | I2C1 未重映射；地址不是 0x3C；上拉缺失 | 检查 CubeMX 重映射勾选；示波器看 SCL 是否有波形
上位机打不开串口 | 端口被占用（串口助手未关）；驱动未装 | 关闭占用程序；重装 CH340 驱动
上位机能发不能收 | TX/RX 未交叉；从机地址/CRC 不符 | 交叉接线；用日志区核对发出的 CRC
曲线偶尔断点 | 上位机未做分包拼帧 | 见 §8.3 第 1 条
电机一转上位机掉线 | 电机干扰经电源串入 USB；共地不良 | 电机电源与 USB 供电分开；加磁环

### 8.3 已知问题与改进建议

以下是代码审阅中发现、尚未修复的问题，按影响程度排序：

1. 上位机正反转命令字与固件定义不一致（功能缺陷）：固件定义 1=正转、2=反转、>2 归零停止；而上位机 slotDirForward() 下发 2、slotDirBackward() 下发 3。实际表现为：点"正转"电机反转，点"反转"电机停止。修复方式二选一——上位机改为下发 1/2，或固件改为与上位机一致的 2/3 映射（推荐前者，保持固件语义简洁）。
2. 寄存器 0x0001 读写语义复用：见 §6.3 说明，建议拆成两个寄存器。
3. 测速只取幅值，不具备方向闭环：abs(delta) 丢弃了方向信息，无法识别"实际转向与命令相反"（如负载倒拖）。若需要四象限运行，应保留符号并纳入 PID 的符号处理。
4. 无通信超时保护：上位机断开后电机按最后指令继续运行。建议增加"超过 N 秒未收到合法帧则停机"的看门狗逻辑。
5. 无独立看门狗（IWDG）：程序跑飞后电机可能保持输出。建议启用 IWDG，并在主循环定时喂狗。
6. 死区补偿未启用：MOTOR_DEAD_ZONE 已定义但补偿代码被注释，低速启动迟缓。
7. OLED 阻塞刷新：每 100 ms 三次 oled_show_string 均为阻塞 I²C 传输，累计占用数毫秒主循环时间，是控制周期抖动的主要来源。可改为 DMA 或降低刷新率（如每 300 ms 一次）。
8. PID 使用浮点运算：Cortex-M3 无 FPU，浮点乘加靠软件库，100 ms 周期内余量充足但可改定点（Q格式）以缩短运算时间。
9. 上位机未做分包拼帧：见 §6.4 说明，建议增加接收缓冲与按长度解析。
10. 用户代码与 CubeMX 生成目录混放：DCmotor.c、modbus.c、encode.c 等用户文件放在 Core/Src，若用 CubeMX 重新生成代码有被覆盖风险。建议迁移到独立的 User/ 目录并在 Keil 中加入 include 路径。
11. 前序实验残留代码：SG90.c、TIM1 舵机 PWM、init_ec11_encode_tim() 与 TIM2 配置均未参与主流程，建议裁剪以减小固件体积与理解成本。

## 9 文档与代码一致性说明

项目目录中另有一份早期文档《基于STM32的直流电机PID调速控制系统.docx》。该文档的部分描述与当前代码实现不一致，为避免后续维护者误判，逐项对照如下（以代码为准）：

项目 | 早期文档描述 | 当前代码实现
PWM 周期 | 100 ms | 1 ms（1 kHz），由 TIM4：PSC=71、ARR=999 决定
控制周期实现方式 | 定时器中断触发 | 主循环软定时HAL_GetTick()，无业务定时中断
编码器所用定时器 | 描述为 TIM4 | TIM3（编码器模式）；TIM4 用于 PWM 输出
掉电存储 | W25Q64 SPI Flash 保存目标速度/运行状态，上电恢复 | 未实现：工程无 SPI 外设配置、无相关代码，上电状态恒为停止、目标 0
测速倍频 | 4 倍频，44 计数/转 | 一致（TIM_ENCODERMODE_TI12，11 线 ×4）
0~100 计数 ↔ 0~100% 占空比映射 | 有 | 一致（PWM_MAX=99，量纲等值设计）
OLED 显示 | 0.96 寸 I²C | 一致（SSD1306，I²C1 重映射）
Modbus-RTU 115200 8N1，站号 1 | 有 | 一致
上位机双曲线 | 有 | 一致（Qt 手绘，200 ms 采样，120 点窗口）
"无超调、稳态误差 0" | 有 | 与第 3 轮参数下的实测一致

若后续要补回"掉电保存"功能，需新增 SPI Flash（如 W25Q64）驱动与参数结构体，并在 motor_cmd/motor_target_speed 变化时写入、上电时读出后恢复运行状态；注意写入需做磨损均衡与写次数限制。

## 10 后续扩展方向

- 协议增强：补齐 Modbus 功能码 0x10（写多寄存器）、0x04（读输入寄存器）与标准异常响应帧（0x83/0x86），提升与通用组态软件（如组态王、Modbus Poll）的兼容性；
- 参数在线整定：把 Kp/Ki/Kd 映射为保持寄存器，上位机可在线改参并立即生效，配合曲线做自整定实验；
- 双闭环：外环速度、内环电流，抑制启动冲击与堵转过流；
- 安全保护：堵转检测（连续 N 周期速度接近 0 而输出饱和即判堵转并停机）、过流采样、通信超时停机、独立看门狗；
- 控制算法对比：在同一平台上对比增量式 PID、位置式 PID 与模糊/PID 复合控制，形成实验数据；
- 多电机扩展：利用 TB6612 的 B 通道再驱动一路电机，Modbus 寄存器按"每电机 3 个寄存器"分组，实现双轮差速；
- 上位机工程化：改用 QCustomPlot 或 Qt Charts 获得更好的坐标轴与导出能力，加入参数配置持久化（QSettings）与数据 CSV 导出；
- 硬件升级：主控换 STM32F103CBT6（128 KB Flash）或 F4 系列（带 FPU），为浮点运算与更复杂算法留余量。

## 附录 A 主要源文件清单

路径 | 说明
STM32F103C8T6_MOTOR/Core/Src/main.c | 主流程、100 ms 节拍、系统时钟配置
STM32F103C8T6_MOTOR/Core/Src/DCmotor.c | 方向控制、PWM 设置、增量式 PID
STM32F103C8T6_MOTOR/Core/Src/encode.c | TIM3 编码器读取与增量计算
STM32F103C8T6_MOTOR/Core/Src/modbus.c | CRC16、帧解析、寄存器读写、应答
STM32F103C8T6_MOTOR/Core/Src/usart.c | USART2 配置与接收中断
STM32F103C8T6_MOTOR/Core/Src/tim.c | TIM1/2/3/4 配置
STM32F103C8T6_MOTOR/Core/Src/oled.c | SSD1306 驱动与字库
STM32F103C8T6_MOTOR/MDK-ARM/STM32F103C8T6_MOTOR.uvprojx | Keil 工程
上位机-QT/Modbus/ModbusRtu/mainwindow.cpp | 上位机界面与交互
上位机-QT/Modbus/ModbusRtu/serialportmanager.cpp | 串口与 Modbus 主站
上位机-QT/Modbus/ModbusRtu/plotwidget.cpp | 双曲线绘制

## 附录 B 参考资料

1. STMicroelectronics，《STM32F103x8/xB 数据手册》与《RM0008 参考手册》；
2. STMicroelectronics，《STM32F1 HAL 库用户手册》（UM1850）；
3. Toshiba，《TB6612FNG 数据手册》；
4. Modbus Organization，《MODBUS over Serial Line Specification V1.02》；
5. 陶永华，《新型 PID 控制及其应用》，机械工业出版社；
6. Qt 官方文档，QSerialPort / QPainter / QTimer 类参考。
