liujiajia-wq/DC-Motor-PID-Speed-Control-Based-on-STM32-and-Modbus/STM32F103C8T6_MOTOR/Core/Src/main.c

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
/* Includes ------------------------------------------------------------------*/
#include "main.h"
#include "i2c.h"
#include "tim.h"
#include "usart.h"
#include "gpio.h"

/* USER CODE BEGIN Includes */
#include "oled.h"
#include "SG90.h"
#include "encode.h"
#include "DCmotor.h"
#include "modbus.h"

/* USER CODE END Includes */


void SystemClock_Config(void);
/**
  * @brief  The application entry point.
  * @retval int
  */
int main(void)
{
  /* USER CODE BEGIN 1 */
	
	int16_t delta = 0;
	char str[32] ={0};
	
	// 定义系统计时
	uint32_t pid_time = 0;

  /* USER CODE END 1 */

  /* MCU Configuration--------------------------------------------------------*/

  /* Reset of all peripherals, Initializes the Flash interface and the Systick. */
  HAL_Init();

  /* Configure the system clock */
  SystemClock_Config();

  /* Initialize all configured peripherals */
  MX_GPIO_Init();
  MX_TIM1_Init();
  MX_TIM2_Init();
  MX_I2C1_Init();
  MX_TIM3_Init();
  MX_TIM4_Init();
  MX_USART2_UART_Init();
  /* USER CODE BEGIN 2 */
	
	oled_init();
	
//	HAL_TIM_PWM_Start(&htim1, TIM_CHANNEL_1);
//	HAL_TIM_PWM_Start(&htim1, TIM_CHANNEL_2);
//	
//	init_ec11_encode_tim();
	init_BMQ370_encode_tim();
	Motor_init();
	
	// 初始化开启接收
	uint8_t rx_byte;
	HAL_UART_Receive_IT(&huart2, &rx_byte, 1);
	
	
	 oled_clear(0);
	// Motor_Run(1, 50);
	
	//set_duty(10);

  /* USER CODE END 2 */

  /* Infinite loop */
  /* USER CODE BEGIN WHILE */
  while (1)
  {
    /* USER CODE END WHILE */

    /* USER CODE BEGIN 3 */
		
//		HAL_GPIO_TogglePin(GPIOC, GPIO_PIN_13);
//		HAL_Delay(1000);
		
//		set_SG90_angle(0);
//		HAL_Delay(1000);
//		set_SG90_angle(90);
//		HAL_Delay(1000);
//		set_SG90_angle(180);
//		HAL_Delay(1000);
//		set_SG90_angle(90);
//		HAL_Delay(1000);
//		


//		    // 1. 匀速
//    SG90_Uniform(0, 180, 1000);
//    SG90_Uniform(180, 0, 1000);
  

//    // 2. 两段梯形
//    SG90_Trapezoid_2Phase(0, 180, 1000); 
//    SG90_Trapezoid_2Phase(180, 0, 1000);


//    // 3. 三次S曲线（你现在用的）
//    SG90_S_Curve_3rd(0, 180, 1000);
//    SG90_S_Curve_3rd(180, 0, 1000);

//			if (0 == Modbus_Parse())// 解析指令
//			{
//				Motor_Run(motor_cmd,motor_target_speed); // 执行电机
//			}
//				
//		
//			delta = get_BMQ370_encode_delte();
//			sprintf(str, "delta:%05d", delta);
//			oled_show_string(0, 0, str);
//			sprintf(str, "cmd:%02d", motor_cmd);
//			oled_show_string(0, 4, str);
//			sprintf(str, "speed:%02d", motor_target_speed);
//			oled_show_string(0, 6, str);
//			HAL_Delay(1000);

		 	Modbus_Parse();
			
			if (HAL_GetTick()-pid_time >= 100)
			{
				pid_time = HAL_GetTick();
				Motor_PID_Loop();
		//		motor_real_speed = get_BMQ370_encode_delte();
				sprintf(str, "target:%03d", motor_target_speed);
				oled_show_string(0, 0, str);
				sprintf(str, "real:%03d", motor_real_speed);
				oled_show_string(0, 2, str);
			}
//			

  }
  /* USER CODE END 3 */
}

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
