liujiajia-wq/DC-Motor-PID-Speed-Control-Based-on-STM32-and-Modbus/STM32F103C8T6_MOTOR/STM32F103C8T6_MOTOR.ioc

Mcu.UserName=STM32F103C8Tx
PA0-WKUP.Signal=S_TIM2_CH1_ETR
PA1.Signal=S_TIM2_CH2
PA13.Signal=SYS_JTMS-SWDIO
PA14.Signal=SYS_JTCK-SWCLK
PA2.Signal=USART2_TX
PA3.Signal=USART2_RX
PA6.Signal=S_TIM3_CH1
PA7.Signal=S_TIM3_CH2
PA8.Signal=S_TIM1_CH1
PA9.Signal=S_TIM1_CH2
PB0.Signal=GPIO_Output
PB1.Signal=GPIO_Output
PB6.Signal=S_TIM4_CH1
PB8.Signal=I2C1_SCL
PB9.Signal=I2C1_SDA
PC13-TAMPER-RTC.Signal=GPIO_Output
PD0-OSC_IN.Signal=RCC_OSC_IN
PD1-OSC_OUT.Signal=RCC_OSC_OUT
