liujiajia-wq/DC-Motor-PID-Speed-Control-Based-on-STM32-and-Modbus/上位机-QT/Modbus/build-ModbusRtu-Desktop_Qt_5_9_0_GCC_64bit-Debug/moc_mainwindow.cpp

/****************************************************************************
** Meta object code from reading C++ file 'mainwindow.h'
**
** Created by: The Qt Meta Object Compiler version 67 (Qt 5.9.0)
**
** WARNING! All changes made in this file will be lost!
*****************************************************************************/

#include "../ModbusRtu/mainwindow.h"
#include <QtCore/qbytearray.h>
#include <QtCore/qmetatype.h>
#if !defined(Q_MOC_OUTPUT_REVISION)
#error "The header file 'mainwindow.h' doesn't include <QObject>."
#elif Q_MOC_OUTPUT_REVISION != 67
#error "This file was generated using the moc from 5.9.0. It"
#error "cannot be used with the include files from this version of Qt."
#error "(The moc has changed too much.)"
#endif

QT_BEGIN_MOC_NAMESPACE
QT_WARNING_PUSH
QT_WARNING_DISABLE_DEPRECATED
struct qt_meta_stringdata_MainWindow_t {
    QByteArrayData data[13];
    char stringdata0[168];
};
#define QT_MOC_LITERAL(idx, ofs, len) \
    Q_STATIC_BYTE_ARRAY_DATA_HEADER_INITIALIZER_WITH_OFFSET(len, \
    qptrdiff(offsetof(qt_meta_stringdata_MainWindow_t, stringdata0) + ofs \
        - idx * sizeof(QByteArrayData)) \
    )
static const qt_meta_stringdata_MainWindow_t qt_meta_stringdata_MainWindow = {
    {
QT_MOC_LITERAL(0, 0, 10), // "MainWindow"
QT_MOC_LITERAL(1, 11, 17), // "refreshSerialPort"
QT_MOC_LITERAL(2, 29, 0), // ""
QT_MOC_LITERAL(3, 30, 12), // "slotOpenPort"
QT_MOC_LITERAL(4, 43, 14), // "slotMotorStart"
QT_MOC_LITERAL(5, 58, 13), // "slotMotorStop"
QT_MOC_LITERAL(6, 72, 14), // "slotDirForward"
QT_MOC_LITERAL(7, 87, 15), // "slotDirBackward"
QT_MOC_LITERAL(8, 103, 18), // "slotSetTargetSpeed"
QT_MOC_LITERAL(9, 122, 15), // "slotUpdateSpeed"
QT_MOC_LITERAL(10, 138, 6), // "target"
QT_MOC_LITERAL(11, 145, 4), // "real"
QT_MOC_LITERAL(12, 150, 17) // "slotAutoReadSpeed"

    },
    "MainWindow\0refreshSerialPort\0\0"
    "slotOpenPort\0slotMotorStart\0slotMotorStop\0"
    "slotDirForward\0slotDirBackward\0"
    "slotSetTargetSpeed\0slotUpdateSpeed\0"
    "target\0real\0slotAutoReadSpeed"
};
#undef QT_MOC_LITERAL

static const uint qt_meta_data_MainWindow[] = {

 // content:
       7,       // revision
       0,       // classname
       0,    0, // classinfo
       9,   14, // methods
       0,    0, // properties
       0,    0, // enums/sets
       0,    0, // constructors
       0,       // flags
       0,       // signalCount

 // slots: name, argc, parameters, tag, flags
       1,    0,   59,    2, 0x08 /* Private */,
       3,    0,   60,    2, 0x08 /* Private */,
       4,    0,   61,    2, 0x08 /* Private */,
       5,    0,   62,    2, 0x08 /* Private */,
       6,    0,   63,    2, 0x08 /* Private */,
       7,    0,   64,    2, 0x08 /* Private */,
       8,    0,   65,    2, 0x08 /* Private */,
       9,    2,   66,    2, 0x08 /* Private */,
      12,    0,   71,    2, 0x08 /* Private */,

 // slots: parameters
    QMetaType::Void,
    QMetaType::Void,
    QMetaType::Void,
    QMetaType::Void,
    QMetaType::Void,
    QMetaType::Void,
    QMetaType::Void,
    QMetaType::Void, QMetaType::Int, QMetaType::Int,   10,   11,
    QMetaType::Void,

       0        // eod
};

void MainWindow::qt_static_metacall(QObject *_o, QMetaObject::Call _c, int _id, void **_a)
{
    if (_c == QMetaObject::InvokeMetaMethod) {
        MainWindow *_t = static_cast<MainWindow *>(_o);
        Q_UNUSED(_t)
        switch (_id) {
        case 0: _t->refreshSerialPort(); break;
        case 1: _t->slotOpenPort(); break;
        case 2: _t->slotMotorStart(); break;
        case 3: _t->slotMotorStop(); break;
        case 4: _t->slotDirForward(); break;
        case 5: _t->slotDirBackward(); break;
        case 6: _t->slotSetTargetSpeed(); break;
        case 7: _t->slotUpdateSpeed((*reinterpret_cast< int(*)>(_a[1])),(*reinterpret_cast< int(*)>(_a[2]))); break;
        case 8: _t->slotAutoReadSpeed(); break;
        default: ;
        }
    }
}

const QMetaObject MainWindow::staticMetaObject = {
    { &QMainWindow::staticMetaObject, qt_meta_stringdata_MainWindow.data,
      qt_meta_data_MainWindow,  qt_static_metacall, nullptr, nullptr}
};


const QMetaObject *MainWindow::metaObject() const
{
    return QObject::d_ptr->metaObject ? QObject::d_ptr->dynamicMetaObject() : &staticMetaObject;
}

void *MainWindow::qt_metacast(const char *_clname)
{
    if (!_clname) return nullptr;
    if (!strcmp(_clname, qt_meta_stringdata_MainWindow.stringdata0))
        return static_cast<void*>(const_cast< MainWindow*>(this));
    return QMainWindow::qt_metacast(_clname);
}

int MainWindow::qt_metacall(QMetaObject::Call _c, int _id, void **_a)
{
    _id = QMainWindow::qt_metacall(_c, _id, _a);
    if (_id < 0)
        return _id;
    if (_c == QMetaObject::InvokeMetaMethod) {
        if (_id < 9)
            qt_static_metacall(this, _c, _id, _a);
        _id -= 9;
    } else if (_c == QMetaObject::RegisterMethodArgumentMetaType) {
        if (_id < 9)
            *reinterpret_cast<int*>(_a[0]) = -1;
        _id -= 9;
    }
    return _id;
}
QT_WARNING_POP
QT_END_MOC_NAMESPACE
