liujiajia-wq/DC-Motor-PID-Speed-Control-Based-on-STM32-and-Modbus/STM32F103C8T6_MOTOR/Core/Src/oled.c

#include "oled.h"
#include "main.h"
#include "i2c.h"


//常用ASCII表
//偏移量32
//ASCII字符集
//偏移量32
//大小:12*6

/************************************6*8的点阵************************************/
const unsigned char F6x8[][6] = {
0x00, 0x00, 0x00, 0x00, 0x00, 0x00,// sp
0x00, 0x00, 0x00, 0x2f, 0x00, 0x00,// !
0x00, 0x00, 0x07, 0x00, 0x07, 0x00,// "
0x00, 0x14, 0x7f, 0x14, 0x7f, 0x14,// #
0x00, 0x24, 0x2a, 0x7f, 0x2a, 0x12,// $
0x00, 0x62, 0x64, 0x08, 0x13, 0x23,// %
0x00, 0x36, 0x49, 0x55, 0x22, 0x50,// &
0x00, 0x00, 0x05, 0x03, 0x00, 0x00,// '
0x00, 0x00, 0x1c, 0x22, 0x41, 0x00,// (
0x00, 0x00, 0x41, 0x22, 0x1c, 0x00,// )
0x00, 0x14, 0x08, 0x3E, 0x08, 0x14,// *
0x00, 0x08, 0x08, 0x3E, 0x08, 0x08,// +
0x00, 0x00, 0x00, 0xA0, 0x60, 0x00,// ,
0x00, 0x08, 0x08, 0x08, 0x08, 0x08,// -
0x00, 0x00, 0x60, 0x60, 0x00, 0x00,// .
0x00, 0x20, 0x10, 0x08, 0x04, 0x02,// /
0x00, 0x3E, 0x51, 0x49, 0x45, 0x3E,// 0
0x00, 0x00, 0x42, 0x7F, 0x40, 0x00,// 1
0x00, 0x42, 0x61, 0x51, 0x49, 0x46,// 2
0x00, 0x21, 0x41, 0x45, 0x4B, 0x31,// 3
0x00, 0x18, 0x14, 0x12, 0x7F, 0x10,// 4
0x00, 0x27, 0x45, 0x45, 0x45, 0x39,// 5
0x00, 0x3C, 0x4A, 0x49, 0x49, 0x30,// 6
0x00, 0x01, 0x71, 0x09, 0x05, 0x03,// 7
0x00, 0x36, 0x49, 0x49, 0x49, 0x36,// 8
0x00, 0x06, 0x49, 0x49, 0x29, 0x1E,// 9
0x00, 0x00, 0x36, 0x36, 0x00, 0x00,// :
0x00, 0x00, 0x56, 0x36, 0x00, 0x00,// ;
0x00, 0x08, 0x14, 0x22, 0x41, 0x00,// <
0x00, 0x14, 0x14, 0x14, 0x14, 0x14,// =
0x00, 0x00, 0x41, 0x22, 0x14, 0x08,// >
0x00, 0x02, 0x01, 0x51, 0x09, 0x06,// ?
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
#define OLED_DAT 0x40

//分辨率
#define XRES 128
#define YRES 64
/****************************
一个字符：8*16像素点
所以OLED可显示16*4行
*******************************/

void oled_write_byte(unsigned char cmd, unsigned char data, int len)
{
	
	unsigned char buff[16] = {0};
	buff[0] = cmd;
	buff[1] = data;

	HAL_I2C_Master_Transmit(&hi2c1, I2C_SLAVE_ADDR<<1, buff, 2, 100);
	//write(fd, buff, len+1);

}

void oled_write_buffer(unsigned char cmd, const unsigned char *data, int len)
{
	int i = 0;
	unsigned char buff[256] = {0};
	buff[0] = cmd;
	for (i = 0; i < len; i++)
	{
		buff[1+i] = data[i];
	}
	HAL_StatusTypeDef status = HAL_I2C_Master_Transmit(&hi2c1, I2C_SLAVE_ADDR<<1, buff, len+1, 100);
	if (status != HAL_OK)
	{
		//Uart_Send_String("HAL_I2C_Master_Transmit err\n");
	
	}
	

	//	write(fd, buff, len+1);
	
}

void oled_set_pos(unsigned char x, unsigned char y)
{  

    oled_write_byte(OLED_CMD, 0xb0 + y, 1);

    oled_write_byte(OLED_CMD, ((x & 0xf0) >> 4) | 0x10, 1);

    oled_write_byte(OLED_CMD, x & 0x0f, 1);

}

int oled_init()
{
	int i;

    unsigned char data[] ={ 0xAE, 0x00, 0x10, 0x40, 0xB0, 0x81, 0xFF, 0xA1, 0xA6,

                 0xA8, 0x3F, 0xC8, 0xD3, 0x00, 0xD5, 0x80, 0xD8, 0x05,

                 0xD9, 0xF1, 0xDA, 0x12, 0xDB, 0x30, 0x8D, 0x14, 0xAF };


    for(i=0; i<sizeof(data); i++)
    {
			oled_write_byte(OLED_CMD, data[i], 1);
    }

	return 0;
}

void oled_show_char(int x, int y, unsigned char chr)
{
	unsigned char c=0, i=0;

    c = chr - ' ';                    

 
    if(x > XRES-1)
    {
       x = 0;

       y = y + 2;
    }

      

    oled_set_pos(x, y);
    oled_write_buffer(OLED_DAT, &F8X16[c*16], 8);

/*
    for(i=0; i<8; i++)
    {

       oled_write_byte(OLED_DAT, F8X16[c*16+i], 1);

    }
*/
   
    oled_set_pos(x,y+1);
    oled_write_buffer(OLED_DAT, &F8X16[c*16+8], 8);  

/*
    for(i=0; i<8; i++)
    {
       oled_write_byte(OLED_DAT, F8X16[c*16+i+8], 1);  
    }
*/
}

void oled_show_string(int x, int y, unsigned char *str)
{

	int j = 0;

	while(str[j] != '\0')
	{     

		if (x >= XRES)
		{
			x = 0;
			y += 2;
		}
		oled_show_char(x, y, str[j]);
		x += 8;

		j++;

	}

}


void oled_clear(unsigned char col)
{  

	unsigned char buff[128] = {0};
  unsigned char i, n;
		
	for (i = 0; i < sizeof(buff); i++)
	{
		buff[i] = col;
	}

    for(i=0; i<8; i++) 
    {  

       oled_write_byte(OLED_CMD, 0xb0 + i, 1);      //设置页地址（0~7）

       oled_write_byte(OLED_CMD, 0x00,   1);        //设置显示位置—列低地址

       oled_write_byte(OLED_CMD, 0x10,   1);        //设置显示位置—列高地址

	
	    oled_write_buffer(OLED_DAT, buff, 128);

//       for(n=0; n<XRES; n++)
//       {

 //          oled_write_byte(OLED_DAT, col, 1);
  //     }

    }

}
