liujiajia-wq/DC-Motor-PID-Speed-Control-Based-on-STM32-and-Modbus/上位机-QT/Modbus/build-ModbusRtu-Desktop_Qt_5_9_0_GCC_64bit-Debug/moc_serialportmanager.cpp

/****************************************************************************
** Meta object code from reading C++ file 'serialportmanager.h'
**
** Created by: The Qt Meta Object Compiler version 67 (Qt 5.9.0)
**
** WARNING! All changes made in this file will be lost!
*****************************************************************************/

#include "../ModbusRtu/serialportmanager.h"
#include <QtCore/qbytearray.h>
#include <QtCore/qmetatype.h>
#if !defined(Q_MOC_OUTPUT_REVISION)
#error "The header file 'serialportmanager.h' doesn't include <QObject>."
#elif Q_MOC_OUTPUT_REVISION != 67
#error "This file was generated using the moc from 5.9.0. It"
#error "cannot be used with the include files from this version of Qt."
#error "(The moc has changed too much.)"
#endif

QT_BEGIN_MOC_NAMESPACE
QT_WARNING_PUSH
QT_WARNING_DISABLE_DEPRECATED
struct qt_meta_stringdata_SerialPortManager_t {
    QByteArrayData data[11];
    char stringdata0[121];
};
#define QT_MOC_LITERAL(idx, ofs, len) \
    Q_STATIC_BYTE_ARRAY_DATA_HEADER_INITIALIZER_WITH_OFFSET(len, \
    qptrdiff(offsetof(qt_meta_stringdata_SerialPortManager_t, stringdata0) + ofs \
        - idx * sizeof(QByteArrayData)) \
    )
static const qt_meta_stringdata_SerialPortManager_t qt_meta_stringdata_SerialPortManager = {
    {
QT_MOC_LITERAL(0, 0, 17), // "SerialPortManager"
QT_MOC_LITERAL(1, 18, 15), // "speedDataUpdate"
QT_MOC_LITERAL(2, 34, 0), // ""
QT_MOC_LITERAL(3, 35, 6), // "target"
QT_MOC_LITERAL(4, 42, 4), // "real"
QT_MOC_LITERAL(5, 47, 15), // "portOpenSuccess"
QT_MOC_LITERAL(6, 63, 16), // "portCloseSuccess"
QT_MOC_LITERAL(7, 80, 11), // "recvRawData"
QT_MOC_LITERAL(8, 92, 4), // "data"
QT_MOC_LITERAL(9, 97, 11), // "sendRawData"
QT_MOC_LITERAL(10, 109, 11) // "onReadyRead"

    },
    "SerialPortManager\0speedDataUpdate\0\0"
    "target\0real\0portOpenSuccess\0"
    "portCloseSuccess\0recvRawData\0data\0"
    "sendRawData\0onReadyRead"
};
#undef QT_MOC_LITERAL

static const uint qt_meta_data_SerialPortManager[] = {

 // content:
       7,       // revision
       0,       // classname
       0,    0, // classinfo
       6,   14, // methods
       0,    0, // properties
       0,    0, // enums/sets
       0,    0, // constructors
       0,       // flags
       5,       // signalCount

 // signals: name, argc, parameters, tag, flags
       1,    2,   44,    2, 0x06 /* Public */,
       5,    0,   49,    2, 0x06 /* Public */,
       6,    0,   50,    2, 0x06 /* Public */,
       7,    1,   51,    2, 0x06 /* Public */,
       9,    1,   54,    2, 0x06 /* Public */,

 // slots: name, argc, parameters, tag, flags
      10,    0,   57,    2, 0x08 /* Private */,

 // signals: parameters
    QMetaType::Void, QMetaType::Int, QMetaType::Int,    3,    4,
    QMetaType::Void,
    QMetaType::Void,
    QMetaType::Void, QMetaType::QByteArray,    8,
    QMetaType::Void, QMetaType::QByteArray,    8,

 // slots: parameters
    QMetaType::Void,

       0        // eod
};

void SerialPortManager::qt_static_metacall(QObject *_o, QMetaObject::Call _c, int _id, void **_a)
{
    if (_c == QMetaObject::InvokeMetaMethod) {
        SerialPortManager *_t = static_cast<SerialPortManager *>(_o);
        Q_UNUSED(_t)
        switch (_id) {
        case 0: _t->speedDataUpdate((*reinterpret_cast< int(*)>(_a[1])),(*reinterpret_cast< int(*)>(_a[2]))); break;
        case 1: _t->portOpenSuccess(); break;
        case 2: _t->portCloseSuccess(); break;
        case 3: _t->recvRawData((*reinterpret_cast< const QByteArray(*)>(_a[1]))); break;
        case 4: _t->sendRawData((*reinterpret_cast< const QByteArray(*)>(_a[1]))); break;
        case 5: _t->onReadyRead(); break;
        default: ;
        }
    } else if (_c == QMetaObject::IndexOfMethod) {
        int *result = reinterpret_cast<int *>(_a[0]);
        void **func = reinterpret_cast<void **>(_a[1]);
        {
            typedef void (SerialPortManager::*_t)(int , int );
            if (*reinterpret_cast<_t *>(func) == static_cast<_t>(&SerialPortManager::speedDataUpdate)) {
                *result = 0;
                return;
            }
        }
        {
            typedef void (SerialPortManager::*_t)();
            if (*reinterpret_cast<_t *>(func) == static_cast<_t>(&SerialPortManager::portOpenSuccess)) {
                *result = 1;
                return;
            }
        }
        {
            typedef void (SerialPortManager::*_t)();
            if (*reinterpret_cast<_t *>(func) == static_cast<_t>(&SerialPortManager::portCloseSuccess)) {
                *result = 2;
                return;
            }
        }
        {
            typedef void (SerialPortManager::*_t)(const QByteArray & );
            if (*reinterpret_cast<_t *>(func) == static_cast<_t>(&SerialPortManager::recvRawData)) {
                *result = 3;
                return;
            }
        }
        {
            typedef void (SerialPortManager::*_t)(const QByteArray & );
            if (*reinterpret_cast<_t *>(func) == static_cast<_t>(&SerialPortManager::sendRawData)) {
                *result = 4;
                return;
            }
        }
    }
}

const QMetaObject SerialPortManager::staticMetaObject = {
    { &QObject::staticMetaObject, qt_meta_stringdata_SerialPortManager.data,
      qt_meta_data_SerialPortManager,  qt_static_metacall, nullptr, nullptr}
};


const QMetaObject *SerialPortManager::metaObject() const
{
    return QObject::d_ptr->metaObject ? QObject::d_ptr->dynamicMetaObject() : &staticMetaObject;
}

void *SerialPortManager::qt_metacast(const char *_clname)
{
    if (!_clname) return nullptr;
    if (!strcmp(_clname, qt_meta_stringdata_SerialPortManager.stringdata0))
        return static_cast<void*>(const_cast< SerialPortManager*>(this));
    return QObject::qt_metacast(_clname);
}

int SerialPortManager::qt_metacall(QMetaObject::Call _c, int _id, void **_a)
{
    _id = QObject::qt_metacall(_c, _id, _a);
    if (_id < 0)
        return _id;
    if (_c == QMetaObject::InvokeMetaMethod) {
        if (_id < 6)
            qt_static_metacall(this, _c, _id, _a);
        _id -= 6;
    } else if (_c == QMetaObject::RegisterMethodArgumentMetaType) {
        if (_id < 6)
            *reinterpret_cast<int*>(_a[0]) = -1;
        _id -= 6;
    }
    return _id;
}

// SIGNAL 0
void SerialPortManager::speedDataUpdate(int _t1, int _t2)
{
    void *_a[] = { nullptr, const_cast<void*>(reinterpret_cast<const void*>(&_t1)), const_cast<void*>(reinterpret_cast<const void*>(&_t2)) };
    QMetaObject::activate(this, &staticMetaObject, 0, _a);
}

// SIGNAL 1
void SerialPortManager::portOpenSuccess()
{
    QMetaObject::activate(this, &staticMetaObject, 1, nullptr);
}

// SIGNAL 2
void SerialPortManager::portCloseSuccess()
{
    QMetaObject::activate(this, &staticMetaObject, 2, nullptr);
}

// SIGNAL 3
void SerialPortManager::recvRawData(const QByteArray & _t1)
{
    void *_a[] = { nullptr, const_cast<void*>(reinterpret_cast<const void*>(&_t1)) };
    QMetaObject::activate(this, &staticMetaObject, 3, _a);
}

// SIGNAL 4
void SerialPortManager::sendRawData(const QByteArray & _t1)
{
    void *_a[] = { nullptr, const_cast<void*>(reinterpret_cast<const void*>(&_t1)) };
    QMetaObject::activate(this, &staticMetaObject, 4, _a);
}
QT_WARNING_POP
QT_END_MOC_NAMESPACE
