liujiajia-wq/DC-Motor-PID-Speed-Control-Based-on-STM32-and-Modbus/上位机-QT/Modbus/build-ModbusRtu-Desktop_Qt_5_9_0_GCC_64bit-Debug/moc_plotwidget.cpp

/****************************************************************************
** Meta object code from reading C++ file 'plotwidget.h'
**
** Created by: The Qt Meta Object Compiler version 67 (Qt 5.9.0)
**
** WARNING! All changes made in this file will be lost!
*****************************************************************************/

#include "../ModbusRtu/plotwidget.h"
#include <QtCore/qbytearray.h>
#include <QtCore/qmetatype.h>
#if !defined(Q_MOC_OUTPUT_REVISION)
#error "The header file 'plotwidget.h' doesn't include <QObject>."
#elif Q_MOC_OUTPUT_REVISION != 67
#error "This file was generated using the moc from 5.9.0. It"
#error "cannot be used with the include files from this version of Qt."
#error "(The moc has changed too much.)"
#endif

QT_BEGIN_MOC_NAMESPACE
QT_WARNING_PUSH
QT_WARNING_DISABLE_DEPRECATED
struct qt_meta_stringdata_PlotWidget_t {
    QByteArrayData data[1];
    char stringdata0[11];
};
#define QT_MOC_LITERAL(idx, ofs, len) \
    Q_STATIC_BYTE_ARRAY_DATA_HEADER_INITIALIZER_WITH_OFFSET(len, \
    qptrdiff(offsetof(qt_meta_stringdata_PlotWidget_t, stringdata0) + ofs \
        - idx * sizeof(QByteArrayData)) \
    )
static const qt_meta_stringdata_PlotWidget_t qt_meta_stringdata_PlotWidget = {
    {
QT_MOC_LITERAL(0, 0, 10) // "PlotWidget"

    },
    "PlotWidget"
};
#undef QT_MOC_LITERAL

static const uint qt_meta_data_PlotWidget[] = {

 // content:
       7,       // revision
       0,       // classname
       0,    0, // classinfo
       0,    0, // methods
       0,    0, // properties
       0,    0, // enums/sets
       0,    0, // constructors
       0,       // flags
       0,       // signalCount

       0        // eod
};

void PlotWidget::qt_static_metacall(QObject *_o, QMetaObject::Call _c, int _id, void **_a)
{
    Q_UNUSED(_o);
    Q_UNUSED(_id);
    Q_UNUSED(_c);
    Q_UNUSED(_a);
}

const QMetaObject PlotWidget::staticMetaObject = {
    { &QWidget::staticMetaObject, qt_meta_stringdata_PlotWidget.data,
      qt_meta_data_PlotWidget,  qt_static_metacall, nullptr, nullptr}
};


const QMetaObject *PlotWidget::metaObject() const
{
    return QObject::d_ptr->metaObject ? QObject::d_ptr->dynamicMetaObject() : &staticMetaObject;
}

void *PlotWidget::qt_metacast(const char *_clname)
{
    if (!_clname) return nullptr;
    if (!strcmp(_clname, qt_meta_stringdata_PlotWidget.stringdata0))
        return static_cast<void*>(const_cast< PlotWidget*>(this));
    return QWidget::qt_metacast(_clname);
}

int PlotWidget::qt_metacall(QMetaObject::Call _c, int _id, void **_a)
{
    _id = QWidget::qt_metacall(_c, _id, _a);
    return _id;
}
QT_WARNING_POP
QT_END_MOC_NAMESPACE
