liujiajia-wq/DC-Motor-PID-Speed-Control-Based-on-STM32-and-Modbus/(commit log)

2026-10-30 Add STM32 DC motor PID control project: STM32F103C8T6 firmware, Qt host app, docs and demo video
2026-10-30 docs: rewrite README with project description, Modbus register map, PID details and build instructions
